70my12/VeriMedINACAP/docs/Informe_Proyecto_de_Titulo (1).docx

VeriMed BT Verificador Rápido Monofásico Portátil, de Control Íntegro por Aplicación Móvil Informe de Ingeniería Conceptual, Básica y de Detalle Unidad 1: Diseño de un proyecto de ingeniería en sistemas electrónicos (ES1 y ES2) Asignatura: Proyectos de Ingeniería en Sistemas Electrónicos (HIPI02) Sección: 2026/P HIPI02/V-IES-N8-P1-C2 — V Santiago Sur IES Nombre del docente: Carlos Alberto Castillo Torres Nombre de los integrantes del grupo: Felipe Martínez Tomás Quezada Santiago − Chile 2026

Índice general

# II. Resumen

Este informe documenta la ingeniería conceptual, básica y de detalle del proyecto VeriMed BT, un verificador rápido monofásico portátil destinado a la comprobación en terreno del error de registro de medidores de energía eléctrica. El proyecto nace de una limitación observada en los equipos comerciales disponibles en el mercado nacional: su interfaz de operación depende de un teclado y pantalla integrados al instrumento, o de un control remoto físico dedicado, lo que encarece el equipo y multiplica sus puntos de falla.

Se generaron y compararon cuatro alternativas de arquitectura para la interfaz de control, evaluadas mediante una matriz de decisión ponderada y un análisis de viabilidad técnica y económica. La alternativa seleccionada reemplaza por completo el teclado, la pantalla y el control remoto físico por una aplicación móvil conectada por Bluetooth de baja energía, lo que redunda en un menor costo de fabricación, un menor consumo eléctrico y una interfaz de usuario actualizable por software. El informe cierra con la ingeniería básica y de detalle de dicha alternativa, dejando definidos el alcance, los materiales a adquirir, los métodos constructivos y los requerimientos de ensayo necesarios para la etapa de implementación.

# III. Introducción

Este documento corresponde a la Unidad 1 de la asignatura Proyectos de Ingeniería en Sistemas Electrónicos (HIPI02), “Diseño de un proyecto de ingeniería en sistemas electrónicos”, y reúne en un solo cuerpo la Evaluación Sumativa 1 (ES1, ingeniería conceptual) y la Evaluación Sumativa 2 (ES2, ingeniería básica y de detalle). La propuesta que aquí se desarrolla fue definida por los estudiantes y validada con el docente guía durante la Actividad 1 de la unidad.

El proyecto seleccionado, VeriMed BT, aborda un problema concreto del trabajo en terreno de las empresas distribuidoras de energía: la verificación periódica de los medidores monofásicos instalados en viviendas exige equipos portátiles cuyo costo y complejidad de mantenimiento son, en la práctica, una barrera para las empresas de menor tamaño. El capítulo IV describe esta problemática con mayor detalle; los capítulos siguientes recorren la propuesta de solución, los objetivos, la generación y selección de alternativas de diseño, la factibilidad técnica y económica, los criterios de eficiencia energética, digitalización y normativa, la planificación del trabajo restante y, finalmente, la ingeniería básica y de detalle de la alternativa elegida.

# IV. Descripción de la problemática

## 4.1 Contexto operacional

Las empresas distribuidoras de energía eléctrica están obligadas, conforme a la normativa del sector, a mantener el consumo registrado por los medidores de sus clientes dentro de los márgenes de error definidos para cada clase de exactitud. En la práctica, esto se traduce en programas de verificación periódica en terreno, en los que un técnico contrasta el medidor instalado contra un patrón de referencia trazable y determina si su error de registro se mantiene dentro de tolerancia.

## 4.2 Soluciones existentes en el mercado

El mercado nacional ofrece equipos especializados para esta tarea, entre ellos el Contrastador Rápido Monofásico Bluetooth para terreno (modelo CIT CRM-BT, de fabricación importada), que determina el error de un medidor en aproximadamente veinte segundos mediante una carga real de referencia y un control remoto inalámbrico dedicado. Este tipo de solución se toma como referencia de competencia a lo largo del presente informe: representa el estándar de desempeño que el proyecto debe igualar, aunque su arquitectura de interfaz —basada en hardware dedicado adicional— es precisamente lo que este proyecto busca simplificar.

Un segundo grupo de soluciones observadas en catálogos de instrumentación corresponde a verificadores con teclado y pantalla incorporados al propio cuerpo del equipo, sin dependencia de un dispositivo externo, pero con un costo de fabricación mayor debido al propio teclado, su sellado mecánico y el software de menús embebido.

## 4.3 Problemas detectados

De la comparación anterior surgen tres problemas recurrentes. Primero, el costo: un equipo de este tipo se transa en el mercado nacional en torno a $1.000.000 por unidad, cifra que limita su adquisición en cantidad suficiente para dotar a todos los técnicos de una empresa distribuidora mediana. Segundo, la duplicidad de hardware: tanto la interfaz local con teclado como el control remoto dedicado añaden componentes, baterías y puntos de falla mecánica que no participan directamente en la medición. Tercero, la rigidez del software: una interfaz embebida en el propio instrumento es costosa de actualizar en terreno, a diferencia de una aplicación instalada en el teléfono del técnico.

## 4.4 Requisitos del mandante

A partir de esta problemática, se acordaron con el docente guía —en el rol de mandante del proyecto— los siguientes requisitos funcionales y no funcionales:

- RF-01: el equipo debe determinar el porcentaje de error de registro de un medidor monofásico en un tiempo comparable al de las soluciones comerciales de referencia, del orden de segundos a un par de minutos.
- RF-02: el equipo debe comunicarse de forma inalámbrica con un dispositivo móvil para su control y para el despliegue de resultados, sin requerir teclado ni pantalla física propia.
- RNF-01: el costo de fabricación del prototipo debe ser sustancialmente menor al precio de referencia de mercado de $1.000.000 por unidad.
- RNF-02: el equipo debe ser portátil, liviano y de fácil manipulación en terreno.
- RNF-03: el diseño debe incorporar protecciones eléctricas de entrada y cumplir con la normativa eléctrica nacional aplicable a instrumentos de verificación.

# V. Propuesta de solución tecnológica

Se propone diseñar y construir, desde cero, VeriMed BT: un verificador rápido monofásico portátil basado en el microcontrolador ESP32, que mide tensión y corriente mediante el circuito integrado de medición de energía AD71056 y calcula el error de registro de un medidor bajo prueba comparándolo contra una carga de referencia conocida. La diferencia respecto de las soluciones descritas en el capítulo anterior está en la interfaz: en VeriMed BT, la configuración del ensayo y la lectura del resultado ocurren íntegramente en una aplicación instalada en el teléfono del técnico, sin teclado ni pantalla propios del equipo de medición.

Esta decisión reduce la cantidad de componentes sujetos a desgaste mecánico, disminuye el costo de fabricación al eliminar hardware de interfaz dedicado y permite que las mejoras futuras del sistema —nuevas pantallas de resultado, reportes exportables, historial de mediciones— se implementen actualizando la aplicación, sin rediseñar el equipo físico. El sistema conserva, en todas sus variantes evaluadas, la etapa de sensado basada en AD71056 y una etapa propia de alimentación y protección desde la red de 220V.

# VI. Objetivos del proyecto

## 6.1 Objetivo general

Diseñar, desde la ingeniería conceptual hasta la ingeniería de detalle, un verificador rápido monofásico portátil de bajo costo basado en ESP32, controlado íntegramente mediante una aplicación móvil, sin teclado ni pantalla física en el equipo.

## 6.2 Objetivos específicos

- Comprender los requisitos del proyecto de acuerdo con la problemática indicada por el mandante.
- Generar y comparar alternativas de interfaz de control del equipo, evaluando su viabilidad técnica y económica.
- Diseñar la etapa de sensado y acondicionamiento de tensión y corriente mediante el circuito integrado AD71056.
- Diseñar la etapa de alimentación y protección eléctrica del equipo a partir de la red de 220V.
- Definir la arquitectura de comunicación inalámbrica entre el equipo y la aplicación móvil de control.
- Establecer los criterios de eficiencia energética, digitalización y normativa aplicables al diseño.
- Desarrollar la ingeniería básica y de detalle de la alternativa seleccionada, incluyendo la selección final de materiales, los métodos constructivos y los requerimientos de prueba.

# VII. Ingeniería conceptual

## 7.1 Descripción general del sistema y principio de medición

El equipo se conecta en paralelo al medidor bajo prueba y a una carga de referencia de valor conocido. El circuito integrado AD71056 mide la tensión y la corriente reales que consume la carga y entrega, en su salida CF, un tren de pulsos cuya frecuencia es proporcional a la energía activa medida. El microcontrolador cuenta estos pulsos de referencia y, en paralelo, los pulsos que entrega el medidor bajo prueba a través de su salida óptica, durante una ventana de tiempo o un número de pulsos definido. El error de registro resulta de comparar ambos conteos, expresado como porcentaje respecto de la energía de referencia.

## 7.2 Diagrama de flujo del proceso de contrastación

La Figura 1 resume el proceso de verificación, desde la conexión del equipo hasta la entrega del resultado en la aplicación móvil.

## 7.3 Generación y comparación de alternativas de interfaz de control

Manteniendo en las cuatro alternativas el mismo núcleo de medición (ESP32 más AD71056), se evaluaron distintas arquitecturas para la interfaz de operación del equipo. Las Alternativas A y B representan las arquitecturas típicas de la competencia descrita en el capítulo IV, tomadas como referencia comparativa; las Alternativas C y D corresponden a propuestas propias del equipo de proyecto que eliminan el teclado y la pantalla física, difiriendo entre sí en el medio de comunicación con el dispositivo móvil.

### 7.3.1 Alternativa A: interfaz local con teclado y pantalla

El equipo incorpora un teclado matricial y una pantalla LCD propios, de modo que el técnico configura el ensayo y lee el resultado directamente en el instrumento, sin depender de un dispositivo externo. Es la arquitectura más autónoma, pero también la de mayor costo de fabricación y la que exige mayor cuidado en el sellado mecánico del teclado en condiciones de terreno.

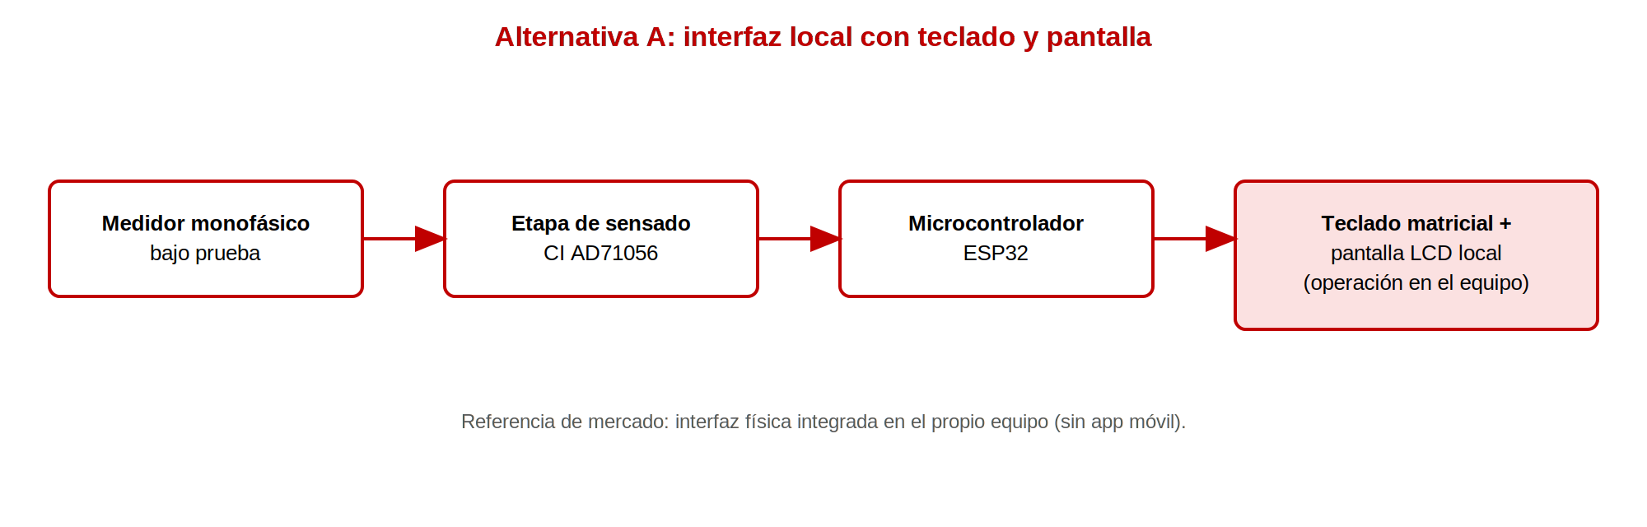
[picture p3: figure]

Figura 2. Diagrama de bloques de la Alternativa A (referencia de competencia).

### 7.3.2 Alternativa B: control remoto físico dedicado

El equipo se comunica por radio con un control remoto físico independiente, que incorpora su propia pantalla, teclado y batería. Esta es la arquitectura de los verificadores comerciales de gama alta descritos en el capítulo IV, tomada aquí como segunda referencia de competencia.

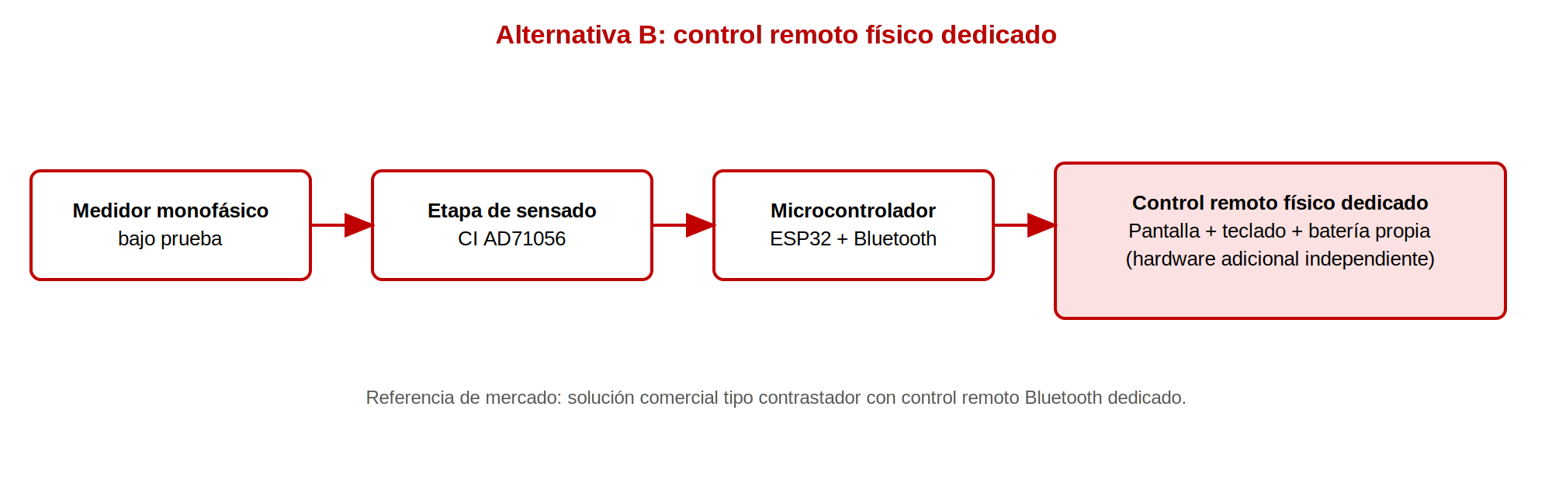
[picture p4: figure]

Figura 3. Diagrama de bloques de la Alternativa B (referencia de competencia).

### 7.3.3 Alternativa C: control íntegro por aplicación móvil vía Bluetooth

El equipo elimina todo teclado, pantalla y control remoto físico. La configuración del ensayo y la lectura del resultado se realizan desde una aplicación instalada en el teléfono del técnico, enlazada por Bluetooth de baja energía. Es la propuesta central de este proyecto.

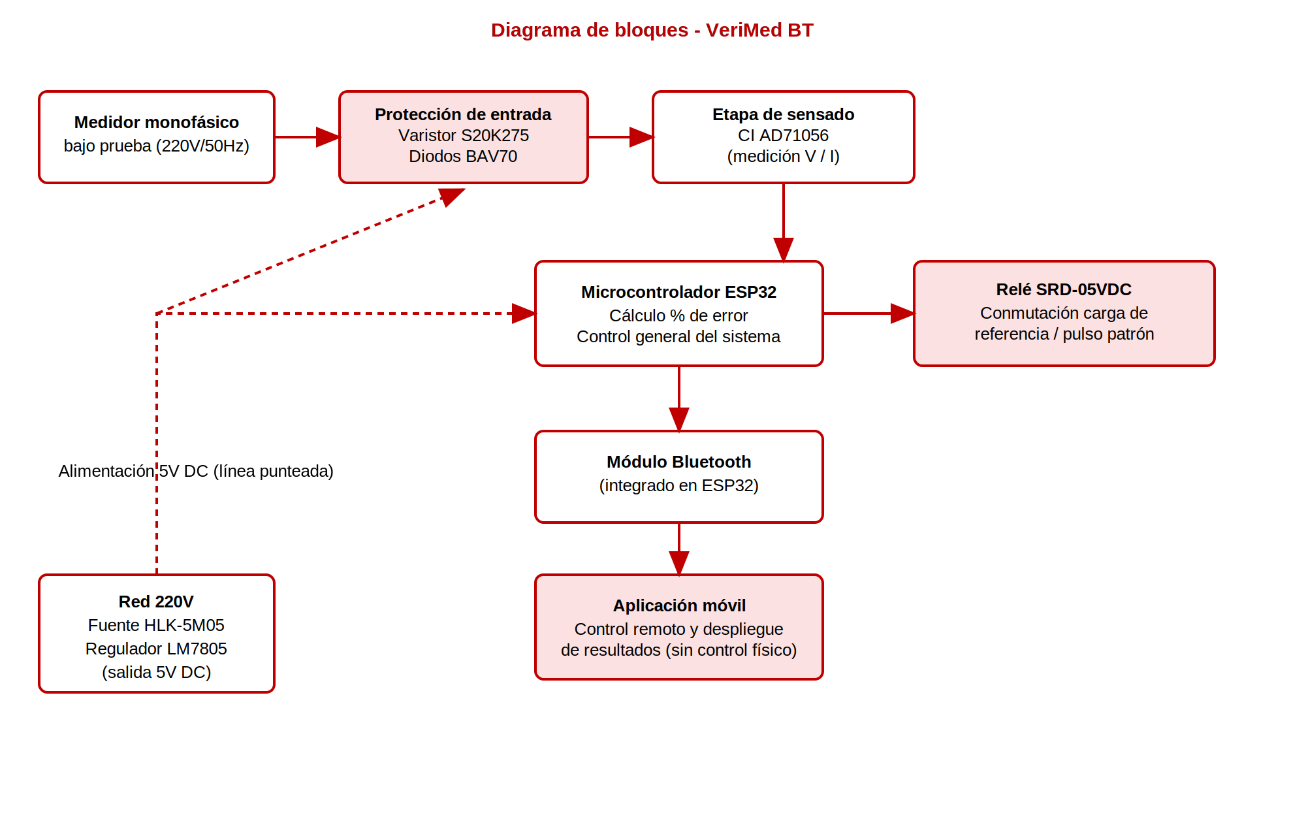
[picture p5: figure]

Figura 4. Diagrama de bloques de la Alternativa C.

### 7.3.4 Alternativa D: interfaz web embebida vía WiFi

Como variante de la Alternativa C, se evaluó reemplazar la aplicación móvil nativa por una página web servida directamente por el ESP32, configurado como punto de acceso WiFi propio, accesible desde el navegador del teléfono sin instalar ninguna aplicación.

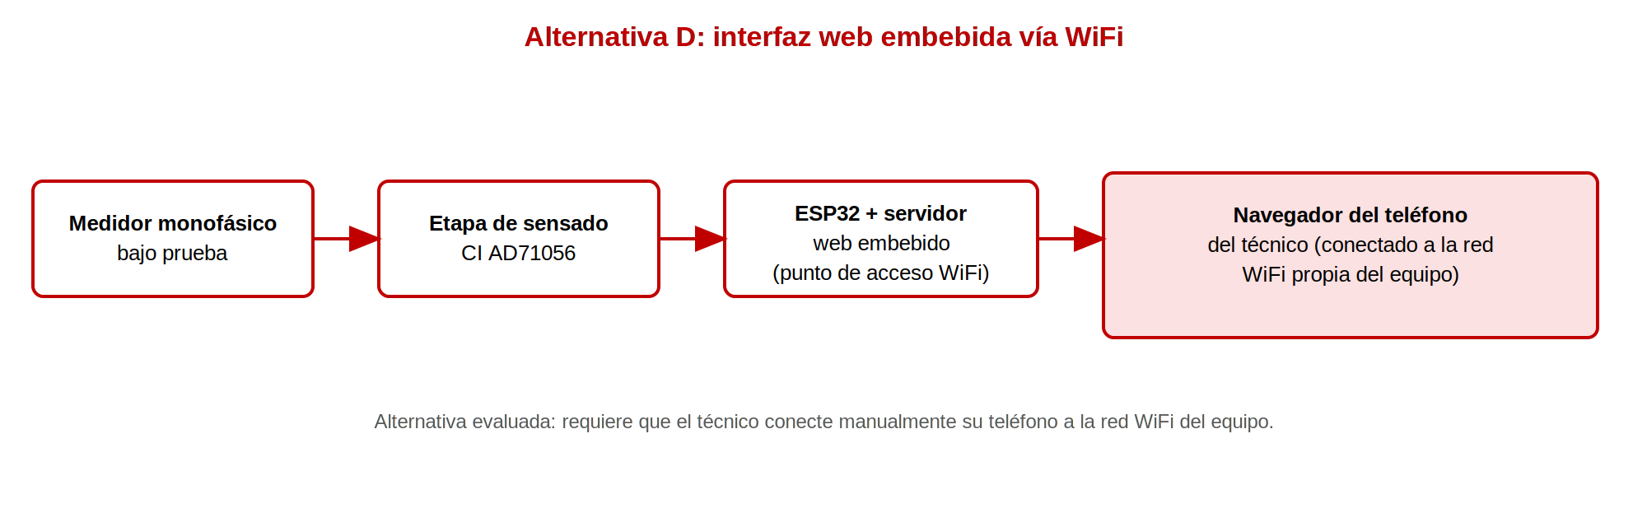
[picture p6: figure]

Figura 5. Diagrama de bloques de la Alternativa D.

### 7.3.5 Matriz de decisión ponderada

Las cuatro alternativas se calificaron en una matriz de decisión ponderada, en escala de 1 (deficiente) a 5 (óptimo), con pesos acordados según la importancia relativa de cada criterio para el mandante.

Criterio | Peso | Alt. A | Alt. B | Alt. C | Alt. D
Costo de fabricación por unidad | 25 % | 3 | 2 | 5 | 5
Portabilidad y tamaño del equipo | 20 % | 3 | 2 | 5 | 5
Facilidad de uso en terreno sin configuración previa | 20 % | 4 | 4 | 5 | 2
Escalabilidad de software (mejoras remotas) | 15 % | 2 | 3 | 5 | 5
Independencia de hardware adicional | 10 % | 4 | 2 | 5 | 5
Madurez / referencia de mercado | 10 % | 5 | 5 | 3 | 2
Puntaje ponderado total | 100 % | 3,35 | 2,75 | 4,75 | 4,00

Tabla 1. Matriz de decisión ponderada entre alternativas. Fuente: elaboración propia (2026).

La Alternativa D obtiene un puntaje competitivo en costo y escalabilidad, pero se penaliza en el criterio de facilidad de uso: exige que el técnico conecte manualmente su teléfono a la red WiFi propia del equipo antes de cada ensayo, un paso adicional que puede fallar si el teléfono mantiene una conexión de datos móviles prioritaria o si hay redes WiFi cercanas con el mismo nombre. La Alternativa C evita este inconveniente, ya que el emparejamiento Bluetooth se mantiene activo entre sesiones y no compite con la conexión de datos del teléfono. Por ese motivo, y por obtener el mayor puntaje ponderado (4,75 sobre 5,00), se selecciona la Alternativa C como base de la ingeniería básica y de detalle.

## 7.4 Especificaciones técnicas conceptuales

- Alimentación: red eléctrica 220 V / 50 Hz, con conversión interna a 5 V DC.
- Núcleo de medición: circuito integrado AD71056, con salida de pulsos proporcional a la energía medida.
- Procesamiento y comunicación: ESP32-WROOM-32, con Bluetooth de baja energía para el enlace con la aplicación móvil.
- Interfaz de usuario: 100 % mediante aplicación móvil; sin teclado ni pantalla física en el equipo.
- Tiempo estimado de ensayo: comparable al de las soluciones comerciales de referencia, del orden de segundos a un par de minutos según la clase de exactitud del medidor bajo prueba.

## 7.5 Filosofía del proyecto

### 7.5.1 Filosofía de operación

El técnico conecta el equipo al medidor bajo prueba y a la carga de referencia, y desde la aplicación móvil inicia el ensayo, configura los parámetros del medidor —constante Kc y clase de exactitud declarada— y observa el resultado en tiempo real, sin manipular controles físicos en el instrumento.

### 7.5.2 Filosofía de control y medición

El ESP32 centraliza el conteo de pulsos del patrón interno (AD71056) y del medidor bajo prueba, calcula el error porcentual y transmite el resultado por Bluetooth a la aplicación, sin almacenamiento ni procesamiento adicional en hardware externo.

### 7.5.3 Filosofía de seguridad

El diseño incorpora protección contra sobretensiones de línea mediante un varistor y contra transitorios de conmutación mediante diodos rápidos en la etapa de entrada de 220 V, resguardando tanto al equipo como al operador.

### 7.5.4 Filosofía de mantenimiento y escalabilidad

Al no existir teclado, pantalla ni control remoto físico, el mantenimiento se concentra en el núcleo de medición; la aplicación móvil puede actualizarse de forma remota para incorporar mejoras de interfaz sin intervenir el hardware del equipo.

### 7.5.5 Filosofía de gestión de datos

Los resultados de cada ensayo —fecha, técnico, medidor y error obtenido— se generan y almacenan en la aplicación móvil, quedando disponibles para su exportación o respaldo posterior.

# VIII. Factibilidad técnica y económica

## 8.1 Viabilidad técnica

La viabilidad técnica de la Alternativa C se sustenta en la matriz de decisión de la sección 7.3.5, donde obtiene el mayor puntaje entre las alternativas evaluadas, y en la disponibilidad comercial de todos sus componentes —ESP32, AD71056 y elementos pasivos— en proveedores nacionales, lo que reduce el riesgo de abastecimiento durante la etapa de implementación.

## 8.2 Viabilidad económica

La evaluación económica se realiza asumiendo que una empresa distribuidora mediana necesita dotar a un equipo de seis técnicos con verificadores portátiles, y compara el costo de desarrollar y fabricar seis unidades propias basadas en la Alternativa C frente al costo de adquirir seis unidades del equipo comercial de referencia (Alternativa 0, $1.000.000 por unidad). Los valores se expresan en pesos chilenos de 2026, con una aproximación propia de la etapa conceptual de ±30 %.

### 8.2.1 Estructura de costos de la alternativa seleccionada

Ítem | Cantidad | Valor unitario | Total
Ingeniería de desarrollo: firmware, app móvil y documentación | 120 h | $10.000 | $1.200.000
Prototipo de laboratorio y componentes de prueba | 1 | $150.000 | $150.000
Ensayos de verificación contra patrón trazable | 1 | $180.000 | $180.000
Capacitación de técnicos en el uso de la aplicación | 8 h | $10.000 | $80.000
Subtotal costos no recurrentes | | | $1.610.000

Tabla 2. Costos no recurrentes de desarrollo (Alternativa C). Fuente: elaboración propia (2026).

Ítem | Cantidad | Valor unitario | Total
Componentes electrónicos (Tabla 9) | 1 | $28.982 | $28.982
Carcasa y ensamblaje mecánico (impresión 3D) | 1 | $15.000 | $15.000
Mano de obra de montaje y prueba | 3 h | $10.000 | $30.000
Costo por equipo | | | $73.982
Total para seis equipos | 6 | $73.982 | $443.892

Tabla 3. Costos recurrentes por equipo (Alternativa C). Fuente: elaboración propia (2026).

La inversión total de la Alternativa C para dotar a los seis técnicos asciende, en consecuencia, a $2.053.892, de los cuales el 78 % corresponde a costos no recurrentes que no se repiten al fabricar unidades adicionales.

### 8.2.2 Comparación económica de las alternativas

Concepto | Alt. A | Alt. B | Alt. C | Alt. D
Costos no recurrentes | $1.400.000 | $2.200.000 | $1.610.000 | $1.300.000
Costo por equipo | $88.982 | $98.982 | $73.982 | $73.982
Inversión total (6 equipos) | $1.933.892 | $2.793.892 | $2.053.892 | $1.743.892
Costo anual de operación y mantenimiento | $350.000 | $500.000 | $300.000 | $320.000
Cumple los requisitos del mandante (RF-02) | No | No | Sí | Parcial

Tabla 4. Comparación económica de las alternativas. Fuente: elaboración propia (2026).

La Alternativa A se marca como no conforme al requisito RF-02, que exige control inalámbrico sin teclado ni pantalla propios. La Alternativa D, si bien es la de menor inversión total, se califica como cumplimiento parcial: satisface la ausencia de teclado, pero su dependencia de una conexión WiFi manual introduce fricción operativa no deseada por el mandante. La Alternativa C combina el cumplimiento pleno de los requisitos con una inversión total intermedia, apenas un 6,2 % superior a la Alternativa D y un 26,5 % inferior a la Alternativa B.

### 8.2.3 Beneficios esperados

El principal beneficio económico de construir seis unidades propias en lugar de adquirir seis equipos comerciales es la diferencia de inversión inicial: $6.000.000 frente a $2.053.892, es decir, un ahorro directo de $3.946.108. A este ahorro de capital se suma un menor costo anual de operación y mantenimiento —$300.000 frente a un estimado de $600.000 para la alternativa comercial, que requiere calibración externa periódica de los seis equipos—, lo que representa un ahorro adicional de $300.000 por año.

### 8.2.4 Indicadores de evaluación económica

Indicador | Valor | Criterio de aceptación
Ahorro de inversión inicial (6 equipos propios v/s comerciales) | $3.946.000 | —
Ahorro anual de operación y mantenimiento | $300.000 | —
Tasa de descuento | 12 % anual | Costo de capital referencial
Valor presente del ahorro de operación a 5 años | $1.081.433 | —
Valor generado total (5 años) | $5.027.433 | Mayor que la inversión propia
Relación beneficio/costo | 2,45 | Mayor que 1

Tabla 5. Indicadores de evaluación económica. Fuente: elaboración propia (2026).

A diferencia de un proyecto que genera ingresos, el valor de esta alternativa proviene íntegramente de un costo evitado: no incurrir en la compra de equipos comerciales. Por ello, el indicador más relevante no es una tasa interna de retorno sino la relación beneficio/costo de 2,45, que indica que, por cada peso invertido en desarrollar la Alternativa C, se generan 2,45 pesos de valor entre ahorro de inversión y ahorro operacional a cinco años.

### 8.2.5 Análisis de sensibilidad

Se evaluó la robustez del resultado ante un escenario en que el costo de desarrollo se subestimó y la diferencia de precio de mercado es menor a la considerada.

Escenario | Inversión propia | Ahorro total (5 años) | Resultado
Base | $2.053.892 | $5.027.433 | Viable
Costo de desarrollo +30 % | $2.536.892 | $4.544.433 | Viable
Precio de mercado −20 % ($800.000/u.) | $2.053.892 | $3.227.433 | Viable
Ambos efectos combinados | $2.536.892 | $2.744.433 | Viable

Tabla 6. Análisis de sensibilidad. Fuente: elaboración propia (2026).

El resultado se mantiene favorable incluso si el costo de desarrollo se subestimó en un 30 % y el precio de referencia de mercado fuese un 20 % menor al considerado, lo que respalda la decisión de continuar con la Alternativa C hacia la ingeniería básica y de detalle.

## 8.3 Selección de la alternativa

Considerando conjuntamente el puntaje técnico ponderado de la sección 7.3.5 y los indicadores económicos de esta sección, se confirma la selección de la Alternativa C: control íntegro por aplicación móvil vía Bluetooth de baja energía, sin teclado ni pantalla física en el equipo.

## 8.4 Viabilidad de producción y venta comercial a escala

Además de evaluarse como una solución interna para dotar a los técnicos de una empresa distribuidora, el mismo diseño de la Alternativa C es susceptible de fabricarse en volumen y comercializarse a terceros —otras empresas distribuidoras, cooperativas eléctricas y contratistas—. Esta sección evalúa esa segunda posibilidad, asumiendo una capacidad de producción de 20 unidades mensuales y un precio de venta de entre $850.000 y $900.000 por unidad, rango que se sitúa levemente bajo el precio de referencia de mercado de $1.000.000 utilizado en las secciones anteriores.

El costo directo por unidad se estima en $99.000, cifra que agrega a los $73.982 de la Tabla 3 (componentes, carcasa y mano de obra de montaje) un costo de calibración final contra patrón trazable de $20.000 y de empaque y manual de $5.000, ambos necesarios para una unidad que se entrega a un cliente externo y no solo para uso interno del propio equipo de técnicos.

Concepto | $850.000/u. | $875.000/u. | $900.000/u.
Ingreso mensual (20 u.) | $17.000.000 | $17.500.000 | $18.000.000
Costo directo mensual (20 u. × $99.000) | $1.980.000 | $1.980.000 | $1.980.000
Costos fijos mensuales estimados | $4.500.000 | $4.500.000 | $4.500.000
Utilidad operacional mensual | $10.520.000 | $11.020.000 | $11.520.000
Utilidad operacional anual | $126.240.000 | $132.240.000 | $138.240.000
Punto de equilibrio (unidades/mes) | 6,0 | 5,8 | 5,6

Tabla 6-bis. Viabilidad de producción y venta a 20 unidades mensuales, según precio de venta. Fuente: elaboración propia (2026).

Los costos fijos mensuales estimados ($4.500.000) suponen un taller de ensamblaje con dos personas dedicadas al montaje, calibración y soporte, más un monto acotado de arriendo y comercialización; estas cifras no provienen de cotizaciones reales y deben verificarse antes de comprometer una decisión de inversión. Aun con esa salvedad, el punto de equilibrio —entre 5,6 y 6 unidades mensuales según el precio— queda muy por debajo de la meta de 20 unidades, lo que deja un margen de seguridad amplio frente a una eventual sobreestimación de la demanda.

Considerando una inversión inicial de $3.610.000 (que agrega a los $1.610.000 de la Tabla 2 un monto de $2.000.000 en equipamiento de ensamblaje y calibración), el período de recuperación se sitúa entre 9 y 10 días de operación a régimen, y el valor actual neto a cinco años, con la tasa de descuento del 12 % anual utilizada en el resto de este capítulo, resulta positivo en los tres escenarios de precio evaluados (entre $451 y $495 millones). Estos resultados deben leerse como una primera aproximación de la etapa conceptual: antes de comprometer la fabricación en volumen, corresponde validar la demanda real de 20 unidades mensuales con clientes potenciales y cotizar en firme los costos fijos de operación.

# IX. Criterios de diseño: eficiencia energética y digitalización

## 9.1 Eficiencia energética del equipo

Se estimó el consumo eléctrico de las cuatro alternativas evaluadas en el capítulo VII, tanto en modo de ensayo activo como en reposo, con el propósito de verificar que la alternativa seleccionada no penaliza la autonomía del sistema.

Consumo estimado | Alt. A | Alt. B | Alt. C | Alt. D
Modo de ensayo activo [W] | 0,92 | 1,03 | 0,65 | 1,18
Modo de reposo [W] | 0,25 | 0,14 | 0,06 | 0,45

Tabla 7. Balance energético comparativo entre alternativas. Fuente: elaboración propia (2026).

La Alternativa C presenta el menor consumo tanto en ensayo activo como en reposo, al prescindir de pantalla, teclado y control remoto, y al utilizar Bluetooth de baja energía en lugar de un enlace WiFi permanente como el de la Alternativa D. Esta diferencia es relevante porque, aunque el equipo se alimenta de la red de 220 V y no depende de batería propia, un menor consumo reduce la disipación térmica de la fuente conmutada y permite dimensionarla con menor margen de sobredimensionamiento.

## 9.2 Eficiencia energética del proceso

Más allá del consumo propio del instrumento, el objetivo del equipo contribuye a la eficiencia energética del sistema eléctrico en un sentido más amplio: al detectar medidores con error de registro fuera de tolerancia, favorece una facturación acorde al consumo real y desincentiva la operación prolongada de medidores descalibrados.

## 9.3 Ciclo de vida y gestión de residuos

Al eliminar el control remoto físico dedicado de la Alternativa B —con su propia batería—, se reduce la cantidad de residuos electrónicos y de pilas o baterías que el equipo genera a lo largo de su vida útil, en línea con los principios de responsabilidad extendida del productor establecidos en la Ley N.º 20.920.

## 9.4 Criterios de digitalización

El sistema digitaliza íntegramente el proceso de verificación: adquisición de datos, cálculo del error y despliegue de resultados ocurren en software, sin intervención de una interfaz física dedicada. Esto habilita mejoras futuras —registro histórico de mediciones, exportación de informes, actualización remota de la aplicación— sin modificar el hardware del equipo.

## 9.5 Indicadores de seguimiento

- Consumo energético medido en laboratorio versus el estimado en la Tabla 7, como verificación de la ingeniería de detalle.
- Número de actualizaciones de la aplicación móvil realizadas sin intervención del hardware, como indicador de la escalabilidad lograda.

# X. Criterios de diseño: condiciones técnicas y normativas

## 10.1 Marco normativo aplicable

El diseño del equipo y la interpretación de sus resultados de medición se enmarcan en la norma internacional IEC 62053-21, que define las clases de exactitud 1 y 2 para medidores estáticos de energía activa, con errores admisibles de ±1 % y ±2 % respectivamente en condiciones de referencia.

La etapa de entrada de 220 V debe diseñarse conforme al Reglamento de Instalaciones Eléctricas (RIC) y a la normativa de la Superintendencia de Electricidad y Combustibles (SEC) aplicable a instrumentos portátiles de verificación en terreno, incluyendo la disposición final de componentes electrónicos conforme a la Ley N.º 20.920 de Responsabilidad Extendida del Productor.

## 10.2 Condiciones técnicas de diseño derivadas

- El error de registro admisible del propio patrón interno del equipo (AD71056) debe ser menor al de la clase de exactitud del medidor bajo prueba, de modo que el error medido sea atribuible al medidor y no al instrumento de verificación.
- La etapa de entrada de 220 V debe incorporar un varistor (S20K275) y diodos rápidos (BAV70) que absorban sobretensiones y transitorios de conmutación antes de que alcancen el circuito de sensado.
- La carcasa del equipo debe mantener una distancia de aislación adecuada entre la etapa de 220 V y la etapa de baja tensión (5 V), conforme a los criterios de seguridad eléctrica del RIC.

# XI. Planificación de actividades

Unidad | Etapa | Actividades planificadas | Semanas
1 | Propuesta y definición del proyecto (Actividad 1) | Levantamiento de la problemática, definición de objetivos y propuesta de solución. | Semanas 1-2
1 | Ingeniería conceptual (Actividad 2 — ES1) | Generación de alternativas, matriz de decisión, especificaciones conceptuales, filosofía del proyecto, viabilidad técnica y económica, criterios de eficiencia energética/digitalización y normativa. | Semanas 3-4
1 | Ingeniería básica y de detalle (Actividad 3 — ES2) | Alcance del proyecto, selección final de materiales, métodos constructivos, aspectos dimensionales y requerimientos de ensayos. | Semanas 5-7
2 | Implementación del proyecto (ES3) | Fabricación de PCB, montaje de componentes, programación del ESP32 y desarrollo de la aplicación móvil. | Semanas 8-13
3 | Gestión de la operación (ES4) | Plan de operación y mantenimiento, presentación final del proyecto. | Semanas 14-17

Tabla 8. Planificación de actividades. Fuente: elaboración propia (2026).

# XII. Especificaciones básicas de equipos y/o instrumentos

La Tabla 9 detalla los componentes electrónicos seleccionados para la Alternativa C, con su función, cantidad y precio de referencia de proveedores nacionales.

Componente | Función en el sistema | Cant. | Precio ref.
ESP32-WROOM-32 | Procesamiento, cálculo del error y comunicación Bluetooth con la app. | 1 | $4.990
Fuente conmutada HLK-5M05 | Alimentación desde 220V AC, reductor ajustable. | 1 | $9.520
Regulador lineal LM7805ACZ | Entrega salida fija de 5V DC para la electrónica de control. | 1 | $1.290
Relé Songle SRD-05VDC-SL-C | Conmutación de la carga de referencia durante el ensayo. | 1 | $990
CI de medición de energía AD71056 (SOP-16) | Medición de tensión y corriente; núcleo de la etapa de sensado. | 1 | $9.200
Varistor S20K275 (V275LA40AP) | Protección contra sobretensiones en la entrada de 220V. | 1 | $540
Diodo BAV70 (SOT-23 SMD) | Protección y acondicionamiento de señal. | 1 | $1.510
Diodo rectificador 1N4007 | Rectificación en la etapa de alimentación. | 2 | $980
Diodo Zener | Regulación y protección de referencia de voltaje. | 1 | $290
Condensador de película 0,01–0,047 µF (X2, R46 MKP) | Supresión de ruido de línea en la entrada de 220V. | Set 10 un. | $1.460
Condensador SMD 106C (10 µF) | Desacople y filtrado en la alimentación. | 4 | $2.790
Condensador electrolítico 110 µF / 25V | Filtrado en la etapa de alimentación DC. | 1 | $470
Condensador electrolítico 470 µF / 50V | Filtrado de la etapa de alimentación conmutada. | 1 | $890
Resistencia de óxido metálico 470 Ω, 2 W (KOA) | Limitación de corriente en la etapa de sensado. | 1 | $772
Resistencias SMD (varios valores) | Acondicionamiento de señal del AD71056 y polarización. | Según diseño | $3.400

Tabla 9. Especificaciones básicas de equipos. Fuente: elaboración propia (2026).

Los componentes pasivos de menor valor —resistencias y condensadores SMD, diodos rectificadores y diodo zener— corresponden a stock genérico de bajo costo, cuyo precio unitario no fue cotizado de forma individual y se confirmará durante la ingeniería de detalle.

# XIII. Ingeniería básica

Esta sección corresponde a la Actividad 3 (ES2) y desarrolla la ingeniería básica de la Alternativa C, seleccionada en el capítulo VIII.

## 13.1 Alcance del proyecto

El alcance de esta etapa comprende el diseño completo de la etapa de sensado y alimentación, la definición de la arquitectura de comunicación Bluetooth con la aplicación móvil, y la selección final de todos los componentes del prototipo. Queda fuera de este alcance el desarrollo del código fuente de la aplicación y del firmware, que se abordan en la etapa de implementación (ES3).

## 13.2 Capacidades y características de productos y servicios del proyecto

- Capacidad de verificar medidores monofásicos de clase 1 y clase 2, con error admisible de ±1 % y ±2 % respectivamente, según IEC 62053-21.
- Comunicación Bluetooth con alcance suficiente para la distancia habitual entre el técnico y el medidor bajo prueba.
- Autonomía de la interfaz limitada por la batería del teléfono del técnico, sin batería adicional dedicada al equipo de medición.

## 13.3 Aspectos normativos en medioambiente y seguridad

- Gestión de residuos electrónicos conforme a la Ley N.º 20.920 (REP), considerando la disposición final de componentes al término de su vida útil.
- Seguridad eléctrica del operador mediante aislación galvánica y protecciones de entrada, conforme al RIC y a la normativa SEC.
- Uso de materiales de carcasa no inflamables o autoextinguibles para la protección mecánica del equipo.

## 13.4 Filosofías operativas

Se profundiza la filosofía de operación definida en el capítulo VII: el técnico no requiere capacitación adicional para el manejo de menús físicos, dado que toda la interacción ocurre en una aplicación con una interfaz gráfica simple, orientada a la lectura rápida del resultado durante la prueba de contraste.

## 13.5 Selección de materiales y equipos de acuerdo a especificaciones

La selección de materiales de la Tabla 9 se mantiene para esta etapa, priorizando proveedores nacionales para asegurar continuidad de abastecimiento y tiempos de entrega acotados durante la implementación.

## 13.6 Aspectos de eficiencia energética y digitalización

Se profundiza lo indicado en el capítulo IX: la fuente conmutada HLK-5M05 se dimensiona con un margen de al menos un 30 % sobre el consumo máximo estimado en la Tabla 7 para el modo de ensayo activo, evitando caídas de tensión que afecten la precisión de la medición durante la transmisión Bluetooth.

# XIV. Ingeniería de detalle

## 14.1 Materiales y equipos a adquirir: cotizaciones y proveedores

La Tabla 10 identifica los proveedores de referencia para cada componente principal, consistentes con el listado de materiales recopilado por el equipo de proyecto.

Componente | Proveedor de referencia | Sitio web
ESP32-WROOM-32 | Vshop | https://vshop.cl/
Fuente conmutada HLK-5M05 | Zona Industrial | https://www.zonaindustrial.cl/
Relé Songle SRD-05VDC-SL-C | Max Electrónica | https://maxelectronica.cl/
Condensador de película X2 | Victronics | https://www.victronics.cl/
Varistor S20K275 | Victronics | https://www.victronics.cl/
CI AD71056 / Diodo BAV70 | AliExpress (proveedor internacional) | https://www.aliexpress.com/
Resistencia de óxido metálico 470 Ω, 2 W | eBay (proveedor internacional) | https://www.ebay.com/

Tabla 10. Proveedores de referencia para cotización. Fuente: elaboración propia (2026).

## 14.2 Métodos constructivos, criterios de aceptabilidad y pruebas

- Fabricación de placa de circuito impreso (PCB) de dos capas mediante proveedor externo, a partir del esquemático y del ruteo desarrollados en la etapa de implementación.
- Montaje de componentes SMD mediante estación de soldadura de temperatura regulable, con inspección visual y prueba de continuidad posterior al montaje.
- Criterio de aceptabilidad: el equipo se considera conforme si, al contrastarlo contra un medidor patrón trazable, el error indicado se mantiene dentro de ±1 % adicional al error propio del patrón utilizado.

## 14.3 Aspectos geométricos y dimensionales

Se estima una carcasa de dimensiones aproximadas 120 × 80 × 40 mm, suficiente para alojar la PCB principal, el relé, la fuente conmutada y el cableado de conexión al medidor bajo prueba y a la carga de referencia, manteniendo la separación eléctrica adecuada entre la etapa de 220 V y la etapa de baja tensión.

## 14.4 Requerimientos de ensayos y pruebas de equipos y sistemas

- Prueba de aislación eléctrica entre la etapa de 220 V y la etapa de baja tensión.
- Prueba funcional de comunicación Bluetooth entre el equipo y la aplicación móvil, verificando alcance y estabilidad del enlace.
- Prueba de exactitud de medición contra un medidor patrón trazable, en al menos tres puntos de carga distintos.
- Prueba de consumo energético del equipo en modo de ensayo y en modo de reposo, contrastada contra los valores estimados en la Tabla 7.

# XV. Conclusiones

La comparación de cuatro alternativas de interfaz de control mostró que eliminar el teclado, la pantalla y el control remoto físico de un verificador rápido monofásico no solo reduce su costo de fabricación, sino que además disminuye su consumo energético y facilita su actualización futura. Entre las dos variantes sin hardware de interfaz dedicado, la comunicación Bluetooth resultó preferible a una interfaz web servida por el propio equipo, porque no exige al técnico una configuración de red adicional en cada uso.

La evaluación económica indica que, para una empresa que necesite equipar a varios técnicos, desarrollar esta solución propia genera un ahorro considerable frente a la compra de equipos comerciales equivalentes, ahorro que se sostiene incluso ante variaciones en el costo de desarrollo o en el precio de mercado de referencia. La ingeniería básica y de detalle desarrollada en este informe deja definidos el alcance, los materiales, los métodos constructivos y los requerimientos de prueba necesarios para avanzar hacia la etapa de implementación (ES3), en la que se recomienda incorporar la retroalimentación del mandante sobre la interfaz de la aplicación móvil, conforme al criterio de evaluación 1.1.6 de la asignatura.

# XVI. Referencias bibliográficas

Comisión Electrotécnica Internacional. (2003). IEC 62053-21: Electricity metering equipment (a.c.) — Particular requirements — Part 21: Static meters for active energy (classes 1 and 2). Ginebra: IEC.

Superintendencia de Electricidad y Combustibles (SEC). Reglamento de Instalaciones Eléctricas (RIC). Santiago, Chile.

Ministerio del Medio Ambiente. (2016). Ley N.º 20.920: Establece marco para la gestión de residuos, la responsabilidad extendida del productor y fomento al reciclaje. Santiago, Chile: Diario Oficial.

Ministerio de Energía. Ley y Plan de Eficiencia Energética. Recuperado de https://energia.gob.cl/ley-y-plan-de-eficiencia-energetica

Analog Devices. AD71056: Energy Metering IC with Serial Port [Hoja de datos]. Recuperado del fabricante.

Espressif Systems. ESP32-WROOM-32 [Hoja de datos y documentación técnica]. Recuperado de https://www.espressif.com/

Vshop. (s.f.). Placa de desarrollo NodeMCU V3 ESP8266 Wifi USB-C Arduino [Ficha de producto]. Recuperado de https://vshop.cl/

Zona Industrial. (s.f.). Fuente modular PCB Mean Well IRM-10 10W [Ficha de producto]. Recuperado de https://www.zonaindustrial.cl/

Max Electrónica. (s.f.). Relé electromecánico modelo SRD-05VDC-SL-C 5V [Ficha de producto]. Recuperado de https://maxelectronica.cl/

Victronics. (s.f.). Varistor V275LA40AP 275V 60kA [Ficha de producto]. Recuperado de https://www.victronics.cl/

COPRELEC. (2024). Contrastador Rápido Monofásico Bluetooth para terreno mod 2024 [Ficha de producto]. Recuperado de https://coprelec.cl/

# XVII. Glosario de términos

Término | Definición
Contrastación | Ensayo comparativo entre la indicación de un medidor de energía y la de un instrumento patrón, con el objeto de determinar su error de medición.
Constante del medidor (Kc) | Cantidad de energía que el medidor registra por cada pulso o revolución de su elemento indicador, expresada en Wh por pulso.
Clase de exactitud | Designación normalizada que fija el error máximo admisible de un medidor en condiciones de referencia.
CF (salida de frecuencia) | Salida de pulsos del circuito AD71056, de frecuencia proporcional a la energía medida.
Mandante | Persona o entidad que define los requisitos de un proyecto y evalúa su cumplimiento; en este informe, el docente guía.
BLE | Bluetooth Low Energy: variante de bajo consumo del estándar Bluetooth, utilizada para la comunicación entre el equipo y la aplicación móvil.
Patrón trazable | Instrumento de referencia cuya exactitud está certificada mediante una cadena ininterrumpida de calibraciones documentadas.
RIC | Reglamento de Instalaciones Eléctricas, normativa chilena que regula el diseño y la ejecución de instalaciones eléctricas de baja tensión.

# XVIII. Anexos

## Anexo A. Ejemplo numérico de cálculo del error de medición

Se presenta un ejemplo del cálculo que ejecuta el equipo, con el objeto de ilustrar el orden de magnitud de las variables involucradas.

Datos del ensayo: medidor electrónico monofásico de clase 2, con constante rotulada de 1.000 imp/kWh, equivalente a Kc = 1 Wh por pulso. Se configura el ensayo con n = 20 pulsos. La cadena de medida del equipo registra V = 220,4 V e I = 4,52 A durante el ensayo. El tiempo transcurrido entre el primer y el vigésimo pulso resulta t = 72,35 s.

Potencia indicada por el medidor: Pi = 1 Wh/pulso × 3600 × 20 pulsos / 72,35 s = 995,16 W.

Potencia de referencia: Pa = V × I = 220,4 V × 4,52 A = 996,2 W.

Error de indicación: e = (Pi − Pa) / Pa × 100 = (995,16 − 996,2) / 996,2 × 100 ≈ −0,10 %, valor que se encuentra dentro de la tolerancia de ±2 % admitida para un medidor de clase 2.

## Anexo B. Estructura del registro de ensayo

Campo | Tipo de dato | Descripción
fecha_hora | Fecha y hora | Instante de emisión del resultado.
tecnico | Texto | Nombre del técnico ejecutante.
serie_medidor | Texto | Número de serie del medidor bajo prueba.
kc | Decimal | Constante del medidor utilizada en el cálculo, en Wh por pulso.
clase | Texto | Clase de exactitud declarada del medidor.
n_pulsos | Entero | Número de pulsos considerados en el ensayo.
t_segundos | Decimal | Tiempo transcurrido entre el primer y el n-ésimo pulso.
error_pct | Decimal | Error porcentual de indicación.
veredicto | Texto | Conforme o no conforme, según la tolerancia de la clase.

VeriMed BT — Informe Unidad 1 (ES1 / ES2) 9

Ingeniería en Sistemas Electrónicos — INACAP

Proyectos de Ingeniería en Sistemas Electrónicos — HIPI02
