70my12/VeriMedINACAP/docs/imagenes/estados_bluetooth.png

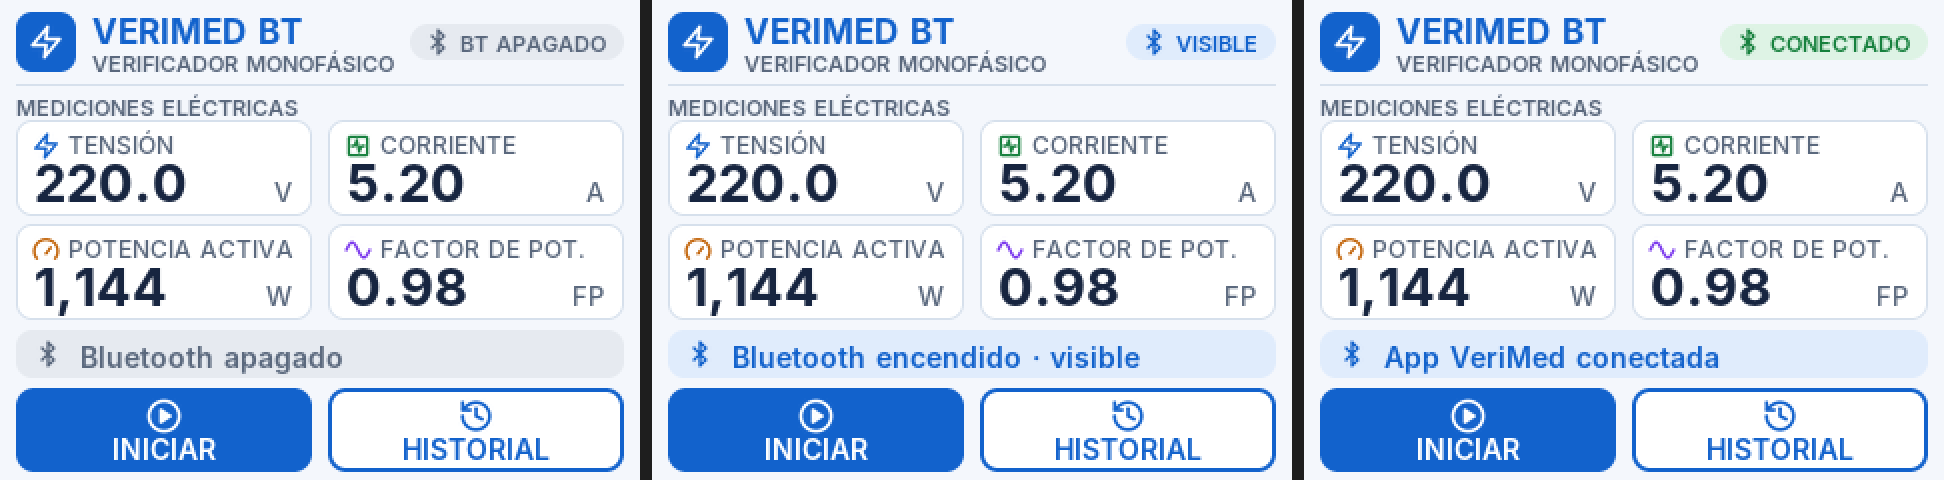
docs/imagenes/estados_bluetooth.png
