70my12/VeriMedINACAP/firmware/verimed7/iconos7.h

// Iconos suavizados (alfa 8 bits) - se dibujan con dibujarIcono()
#pragma once
#include <pgmspace.h>

struct Icono { const uint8_t *alfa; uint8_t w, h; };

const uint8_t I7_ZAP_30_A[] PROGMEM = {
  0,0,0,0,0,0,0,0,0,0,0,0,0,0,1,0,0,0,0,0,0,0,0,0,0,0,0,0,0,0,
  0,0,0,0,0,0,0,0,0,0,0,0,0,3,0,140,202,60,0,2,0,0,0,0,0,0,0,0,0,0,
  0,0,0,0,0,0,0,0,0,0,0,0,5,0,116,255,255,174,0,4,0,0,0,0,0,0,0,0,0,0,
  0,0,0,0,0,0,0,0,0,0,0,4,0,78,255,248,253,134,0,4,0,0,0,0,0,0,0,0,0,0,
  0,0,0,0,0,0,0,0,0,0,3,0,45,243,253,249,255,101,0,4,0,0,0,0,0,0,0,0,0,0,
  0,0,0,0,0,0,0,0,0,2,1,20,221,255,252,253,255,72,0,3,0,0,0,0,0,0,0,0,0,0,
  0,0,0,0,0,0,0,0,1,3,3,191,255,255,255,255,254,44,0,2,0,0,0,0,0,0,0,0,0,0,
  0,0,0,0,0,0,0,0,4,0,154,255,255,207,204,255,240,21,0,1,0,0,0,0,0,0,0,0,0,0,
  0,0,0,0,0,0,0,4,0,115,255,252,237,37,205,255,218,4,1,1,1,1,1,1,1,1,0,0,0,0,
  0,0,0,0,0,0,4,0,78,255,250,254,64,5,242,255,193,0,1,0,0,0,0,0,0,0,1,2,0,0,
  0,0,0,0,0,3,0,45,243,251,255,108,0,47,252,255,164,1,4,1,1,1,1,1,0,1,0,0,0,0,
  0,0,0,0,2,1,20,221,254,255,145,0,2,71,253,251,235,214,214,214,214,214,214,215,215,214,203,62,0,2,
  0,0,0,1,3,3,191,255,255,182,0,6,0,94,255,255,255,255,255,255,255,255,255,255,255,255,255,181,0,4,
  0,0,0,4,0,154,255,255,214,15,2,4,1,25,194,220,214,214,214,214,213,215,207,239,253,250,250,74,0,3,
  0,0,5,0,115,255,254,239,39,0,4,0,1,0,0,5,1,1,1,0,4,0,47,236,251,255,103,0,3,0,
  0,3,0,78,255,251,243,63,0,0,0,0,0,0,0,0,0,0,0,1,0,20,222,255,255,142,0,4,0,0,
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
  0,0,0,0,0,0,0,0,3,0,3,117,235,255,255,251,248,250,255,255,255,255,255,255,255,255,250,248,251,255,255,235,117,3,0,3,0,0,0,0,0,0,0,0,
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
};
const Icono I7_EQUIS_44 = { I7_EQUIS_44_A, 44, 44 };
