70my12/VeriMedINACAP/firmware/verimed_v2/iconos.h

// Iconos suavizados (alfa 8 bits) - se dibujan con dibujarIcono()
#pragma once
#include <pgmspace.h>

struct Icono { const uint8_t *alfa; uint8_t w, h; };

const uint8_t ICO_ZAP_18_A[] PROGMEM = {
  0,0,0,0,0,0,0,2,0,62,30,0,1,0,0,0,0,0,
  0,0,0,0,0,0,3,0,57,255,145,0,4,0,0,0,0,0,
  0,0,0,0,0,2,0,31,229,255,116,0,4,0,0,0,0,0,
  0,0,0,0,1,2,10,206,255,255,84,0,3,0,0,0,0,0,
  0,0,0,1,4,0,173,255,199,255,58,3,6,3,3,3,1,0,
  0,0,0,5,0,131,255,113,128,255,11,0,0,0,0,0,0,0,
  0,0,4,0,92,255,174,0,180,248,83,77,78,79,80,78,22,0,
  0,3,0,58,255,209,14,4,206,255,255,255,255,255,255,255,145,0,
  2,0,29,232,221,17,0,0,33,76,76,80,75,116,250,222,35,1,
  2,21,202,254,120,57,66,61,60,25,0,0,0,200,246,49,0,2,
  0,129,255,255,255,255,255,255,255,215,6,4,186,255,82,0,4,0,
  0,25,92,95,95,94,94,94,240,200,0,147,255,118,0,5,0,0,
  0,0,0,0,0,0,0,0,252,146,88,255,157,0,4,1,0,0,
  0,1,4,4,4,6,4,43,255,196,252,197,4,3,1,0,0,0,
  0,0,0,0,0,3,0,68,255,255,227,23,0,2,0,0,0,0,
  0,0,0,0,0,4,0,98,254,243,50,0,3,0,0,0,0,0,
  0,0,0,0,0,4,0,130,255,80,0,4,0,0,0,0,0,0,
  0,0,0,0,0,1,0,32,80,0,2,0,0,0,0,0,0,0,
};
const Icono ICO_ZAP_18 = { ICO_ZAP_18_A, 18, 18 };

const uint8_t ICO_ZAP_14_A[] PROGMEM = {
  0,0,0,0,1,2,0,111,21,0,1,0,0,0,
  0,0,0,0,5,0,130,255,57,0,3,0,0,0,
  0,0,0,4,0,94,255,246,34,0,2,0,0,0,
  0,0,3,0,60,255,209,234,14,1,2,1,1,0,
  0,2,0,26,246,148,112,226,0,0,0,0,0,0,
  1,2,7,218,216,0,170,255,218,223,213,202,176,3,
  2,0,173,220,4,0,48,118,139,135,175,255,148,1,
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
  3,0,70,255,229,68,0,0,0,0,0,0,60,220,255,83,0,3,
  0,3,0,73,240,255,193,110,69,67,106,187,255,247,84,0,3,0,
  0,0,3,0,26,144,240,255,255,255,255,244,152,32,0,3,0,0,
  0,0,0,3,0,0,14,61,95,96,63,17,0,0,3,0,0,0,
};
const Icono ICO_EQUIS_18 = { ICO_EQUIS_18_A, 18, 18 };
