70my12/VeriMedINACAP/(commit log)

2026-09-21 Informe Proyecto de Titulo.
    Preentrega Informe Ingeniería Conceptual
2026-09-21 PreEntrega de Informe (Formativa)
2026-09-21 Update link for PreeInforme de Proyecto de Título
2026-11-05 Integra firmware, app y documentación del prototipo
    - firmware/: verimed_v2 (pantalla táctil, ensayo por pulsos, BLE), diagnóstico de
    hardware, calibración táctil y User_Setup.h de TFT_eSPI
    - app/: código Flutter (BLE, ensayo, escáner de serie, foto con GPS, PDF con SHA-256)
    - docs/: hardware, protocolo BLE, configuración de la app e imágenes; el informe se
    mueve a docs/ según la estructura del README
    - README actualizado con el diseño actual y el estado de ES3/ES4
    - Se elimina verimed-bt.zip (su contenido queda descomprimido en el repositorio)
    - .gitignore: se agregan reglas de Flutter, Arduino y secretos de Firebase
    Cl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
2026-11-10 Agrega la versión del equipo con pantalla de 7" (VIEWE ESP32-S3)
    - firmware/verimed7: verificador completo en 800x480 con LovyanGFX
    (gráfico de potencia en vivo, resultado a pantalla completa, ajustes,
    historial) y el mismo protocolo BLE que el CYD
    - Dibujo por franjas en RAM interna, repintado mínimo y PCLK de 14 MHz
    para evitar el desfase de la imagen RGB
    - Pila del loop en 32 KB (glifos de 112 px) y guardado en flash en un
    solo bloque con transición suave
    - firmware/verimed7_prueba: prueba de pantalla, colores, PSRAM y táctil
    - docs/PANTALLA_7.md y actualización de README y HARDWARE.md
    Claude-Session: https://claude.ai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
